jasonfrowe/2600MultiCart/(threads)

Thread 1 (2024-02-29):

Documentation for Non-W Pico Build Process

aaronsmithdev, 2024-02-29:
Thanks for the awesome project! It's working perfectly on my 2600+. You're a lifesaver. I have an Uno Cart and was upset to find it didn't work on the 2600+. I started looking around for multi-cart options but found most of them were overly complex or didn't have a PCB. I ran across your earlier revision, was ready to build it, then you released this one! Awesome!

I did notice a couple issues with documentation during the build process, however, and wanted to pass them along (since they both have to do with documentation, I thought I'd wrap them into one issue).

1. The instructions seem to be specific to the Pico W. I built mine with a standard Pico and had to take a look at the Cmake list to find that the proper cmake command was:

**cmake .. -DPICO_BOARD=pico**

2. After running cmake, I tried to run make and encountered this error:

_[  8%] Building C object CMakeFiles/pico_rom_wifi.dir/rom_wifi.c.obj
/home/aaron/2600/rom_wifi.c:17:10: fatal error: pico/cyw43_arch.h: No such file or directory
   17 | #include "pico/cyw43_arch.h" // Library for PICO_W_

  I found in the build list that the command I needed to run was:

  **make pico_rom**

After that, I had the UF2, flashed it to the Pico, and was able to play games without issue. I think dropping those couple notes in the documentation could save others some time (if everyone isn't using Pico W already). No other road bumps to speak of. It was super quick to assemble once the PCB came in and your instructions and code easy enough to work through to get to that resolution pretty easily.

I also plan on working on a case and will pass it along if you don't get to it first. If I do, I'll submit that as a pull request. Nice work! I appreciate you making it available to the community!

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

jasonfrowe, 2024-03-13:
Thanks for the awesome feedback.  I will incorporate your suggestions into the documentation to help with others.

Glad to hear the cart is working for you.  It's been a lot of fun so far.

Closed 2024-03-17.

Thread 2 (2024-03-17):

options to load everything via SD card

manotroll, 2024-03-17:
Wouldn't it be possible to convert all the Atari 2600 roms and put them on an SD card and choose from a menu?
Or add a matrix of buttons in place of the 4 keys and enter a number that would load the games to the pico's RAM?
Thank you for making the files available

jasonfrowe, 2024-03-17:
Not with the 2600+.  The 2600+ cannot interact with the cart, it will only dump the ROM, hence the need for a more analog approach with dip-switches.

manotroll, 2024-03-17:
I'm sure I'm going to use it on the old Atari 2600
and there are others like everdrive and derivatives that have a menu although they use a much more expensive chip for control
I don't know how much space is left after the conversions but sending commands via serial or with an LCD even with a second pi to send the files
I had the boards made when everything arrives I'll be able to see if the Atari is still working because someone disappeared with my cartridges

jasonfrowe, 2024-03-19:
I haven't tested the board on a real 2600, since I do not own one.  If you run into problems we can discuss how to compile with overclocking or adding an external power-source to deal with potential timing issues.

Other multi-carts are interacting with the 2600 via the cartridge slot.  With the 2600+, the cart is dumped and run through an emulator, so an on-screen menu is not possible.

I am working on a WIFI version that would allow messages via MQTT to allow for cart swapping with a simple python script that can probably be easily implemented into a local web-service.  It's about 95% complete, I just trying to resolve some interrupt instability that can affect a currently running game often enough to be annoying.

Thread 3 (2024-06-08):

3D Printed Cartridge Model - Alpha

aaronsmithdev, 2024-06-08:
UPDATE
----------------------
I've decided to go ahead and create a pull request in-case you want to use this.
----------------------

Hi Jason,

I didn't want to open this as an issue, but I also didn't want to ask that it be submitted to the project in its current state. I've cobbled together a 3D printed cartridge that's working for me, but it definitely has some issues. While I've created some small parts for projects, I haven't really taken anything like this on before. I wanted to get something functional together quickly, so I started from someone else's work. I hacked together pieces here and shaved off bits there until I had met the bare minimum and called it quits.

I'm using a DLP printer and had to use supports or deal with unwanted patterns on the outside of the case. The supports then made it necessary to sand the portions where the two halves meet to get everything to sit comfortably. I didn't use calipers and the measurements may be off so anyone else using it, regardless of whether using a DLP printer or supports, may have to sand. I also neglected to create a version that can support the dip switches and reset on the same side of the board as the Pico. And, although I would have rather had a small shaft that fit into a hole in the case to trigger the reset, I found myself happy with what I had.

I've used this with five PCBs and they all work fine after the sanding I mentioned. Instead of just leaving this to die, and in-case nobody involved with the project had been able to get something better in-place, I wanted to at least pass along the files.

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

[2600multicart_cartridge_alpha.zip](https://github.com/user-attachments/files/15749081/2600multicart_cartridge_alpha.zip)

Closed 2024-06-09.
