jasonfrowe/2600MultiCart/(commit log)

2024-02-10 Software to build Pico cart
2024-02-10 Gerber folder
2024-02-10 Adding Gerbers
2024-02-11 Unstable WIFI build
    WIFI builds have stability problems.
    [mqtt_setup.h, send_rom.py]
2024-03-13 Update README.md to reflect non-W PIco
2024-03-13 Update README.md: Update for R3 resistor
